ScotteC/candleLightFD/candleLightfd-S01.kicad_pcb

## KiCad design candleLightfd-S01.kicad_pcb (2024-10-16)

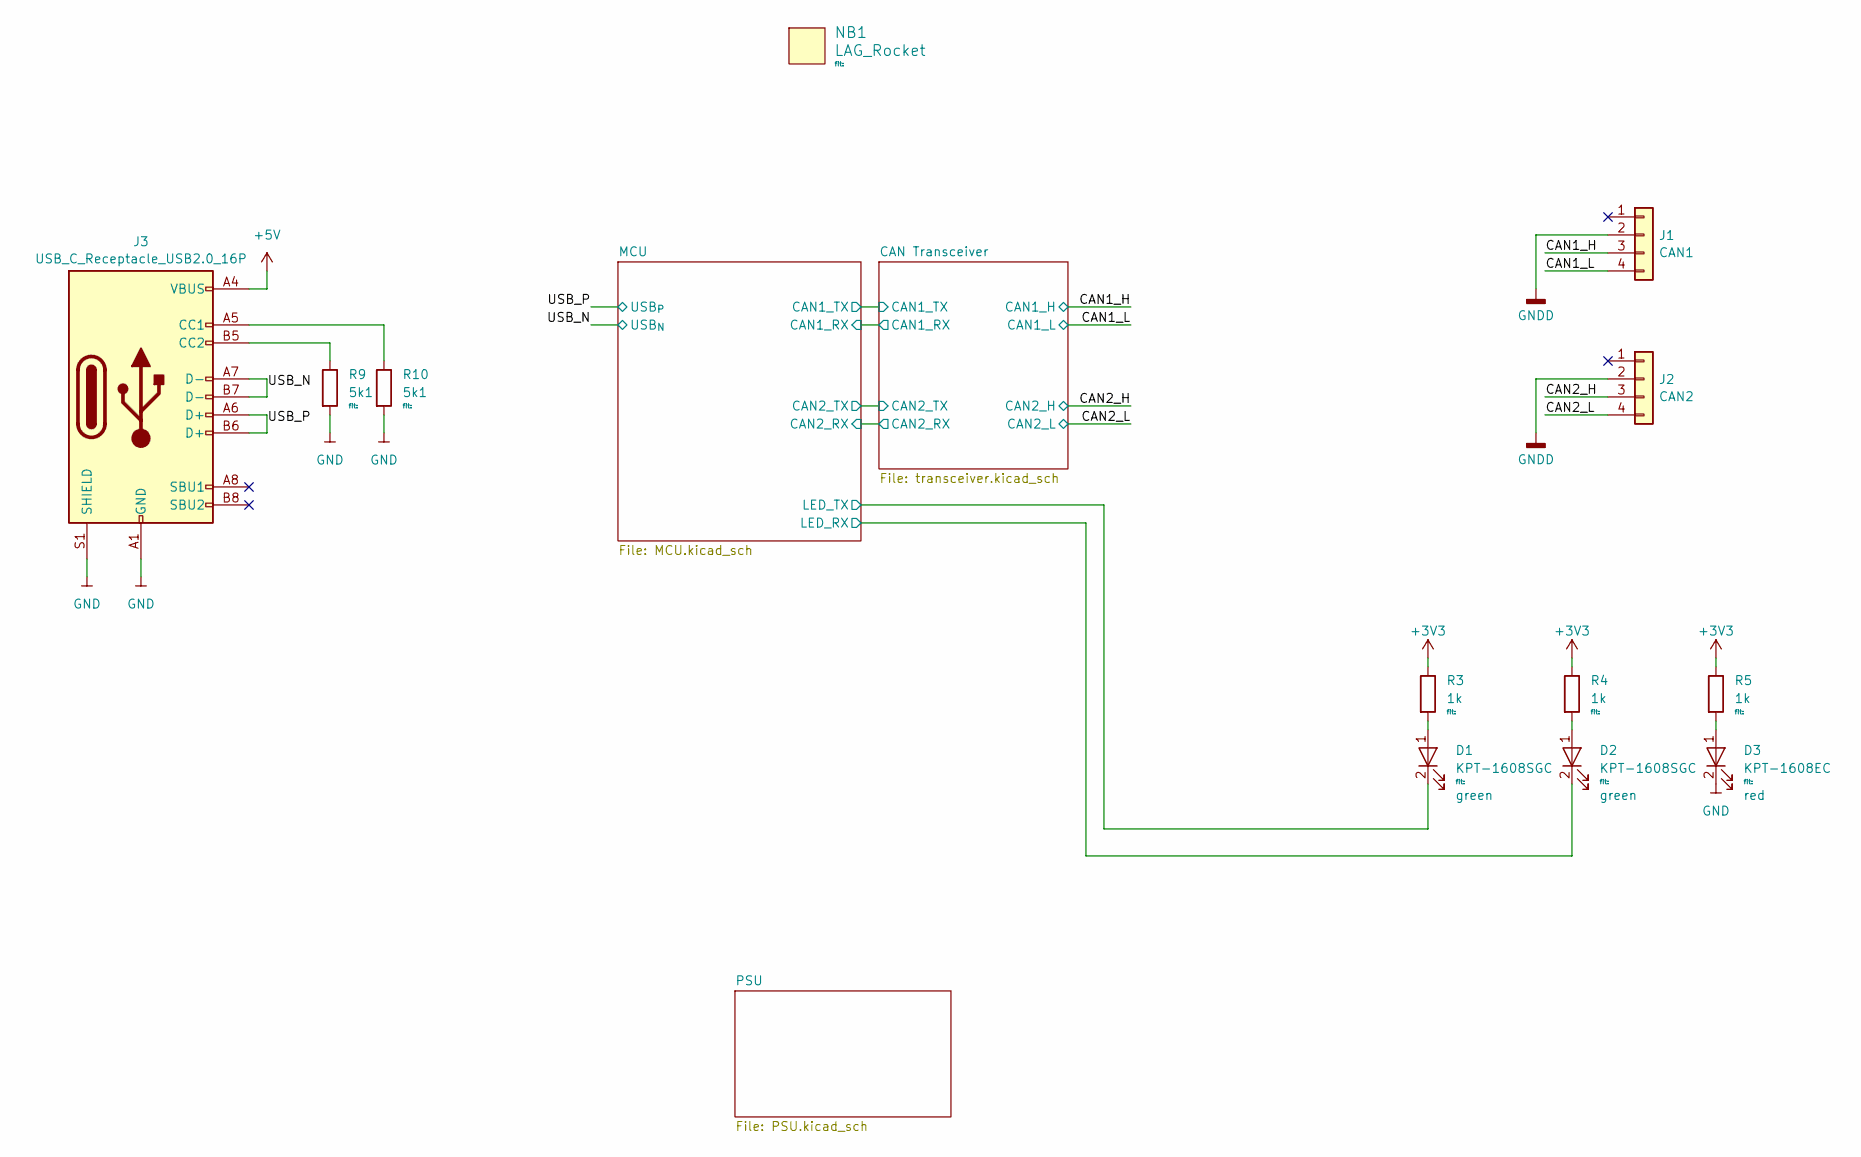
[picture p1: schematic candleLightfd-S01.kicad_sch, ${title}]

Parts:
D1, D2: KPT-1608SGC; LED_0603_1608Metric; MPN KPT-1608SGC
D3: KPT-1608EC; LED_0603_1608Metric; MPN KPT-1608EC
J1: CAN1; PSS254_1x04_Horizontal
J2: CAN2; PSS254_1x04_Horizontal
J3: USB_C_Receptacle_USB2.0_16P; USB_C_Receptacle_GCT_USB4085; MPN GSB1C411111DS1HR; mouser 523-GSB1C411111DS1HR
NB1: LAG_Rocket; lag_rocket_14.5mmx15mm
R3, R4, R5: 1k; R_0603_1608Metric
R9, R10: 5k1; R_0603_1608Metric

Connections:
+3V3: R3.1, R4.1, R5.1; also elsewhere on the board
+5V: J3.A4 (VBUS), J3.A9 (VBUS), J3.B4 (VBUS), J3.B9 (VBUS); also elsewhere on the board
/CAN1_H: J1.3; also elsewhere on the board
/CAN1_L: J1.4; also elsewhere on the board
/CAN2_H: J2.3; also elsewhere on the board
/CAN2_L: J2.4; also elsewhere on the board
/MCU/LED_RX: D2.2 (K); also elsewhere on the board
/MCU/LED_TX: D1.2 (K); also elsewhere on the board
/USB_N: J3.A7 (D-), J3.B7 (D-); also elsewhere on the board
/USB_P: J3.A6 (D+), J3.B6 (D+); also elsewhere on the board
GND: D3.2 (K), J3.A1 (GND), J3.A12 (GND), J3.B1 (GND), J3.B12 (GND), J3.S1 (SHIELD), R9.2, R10.2; also elsewhere on the board
GNDD: J1.2, J2.2; also elsewhere on the board
unnamed: D1.1 (A), R3.2
unnamed: D2.1 (A), R4.2
unnamed: D3.1 (A), R5.2
unnamed: J3.A5 (CC1), R10.1
unnamed: J3.B5 (CC2), R9.1

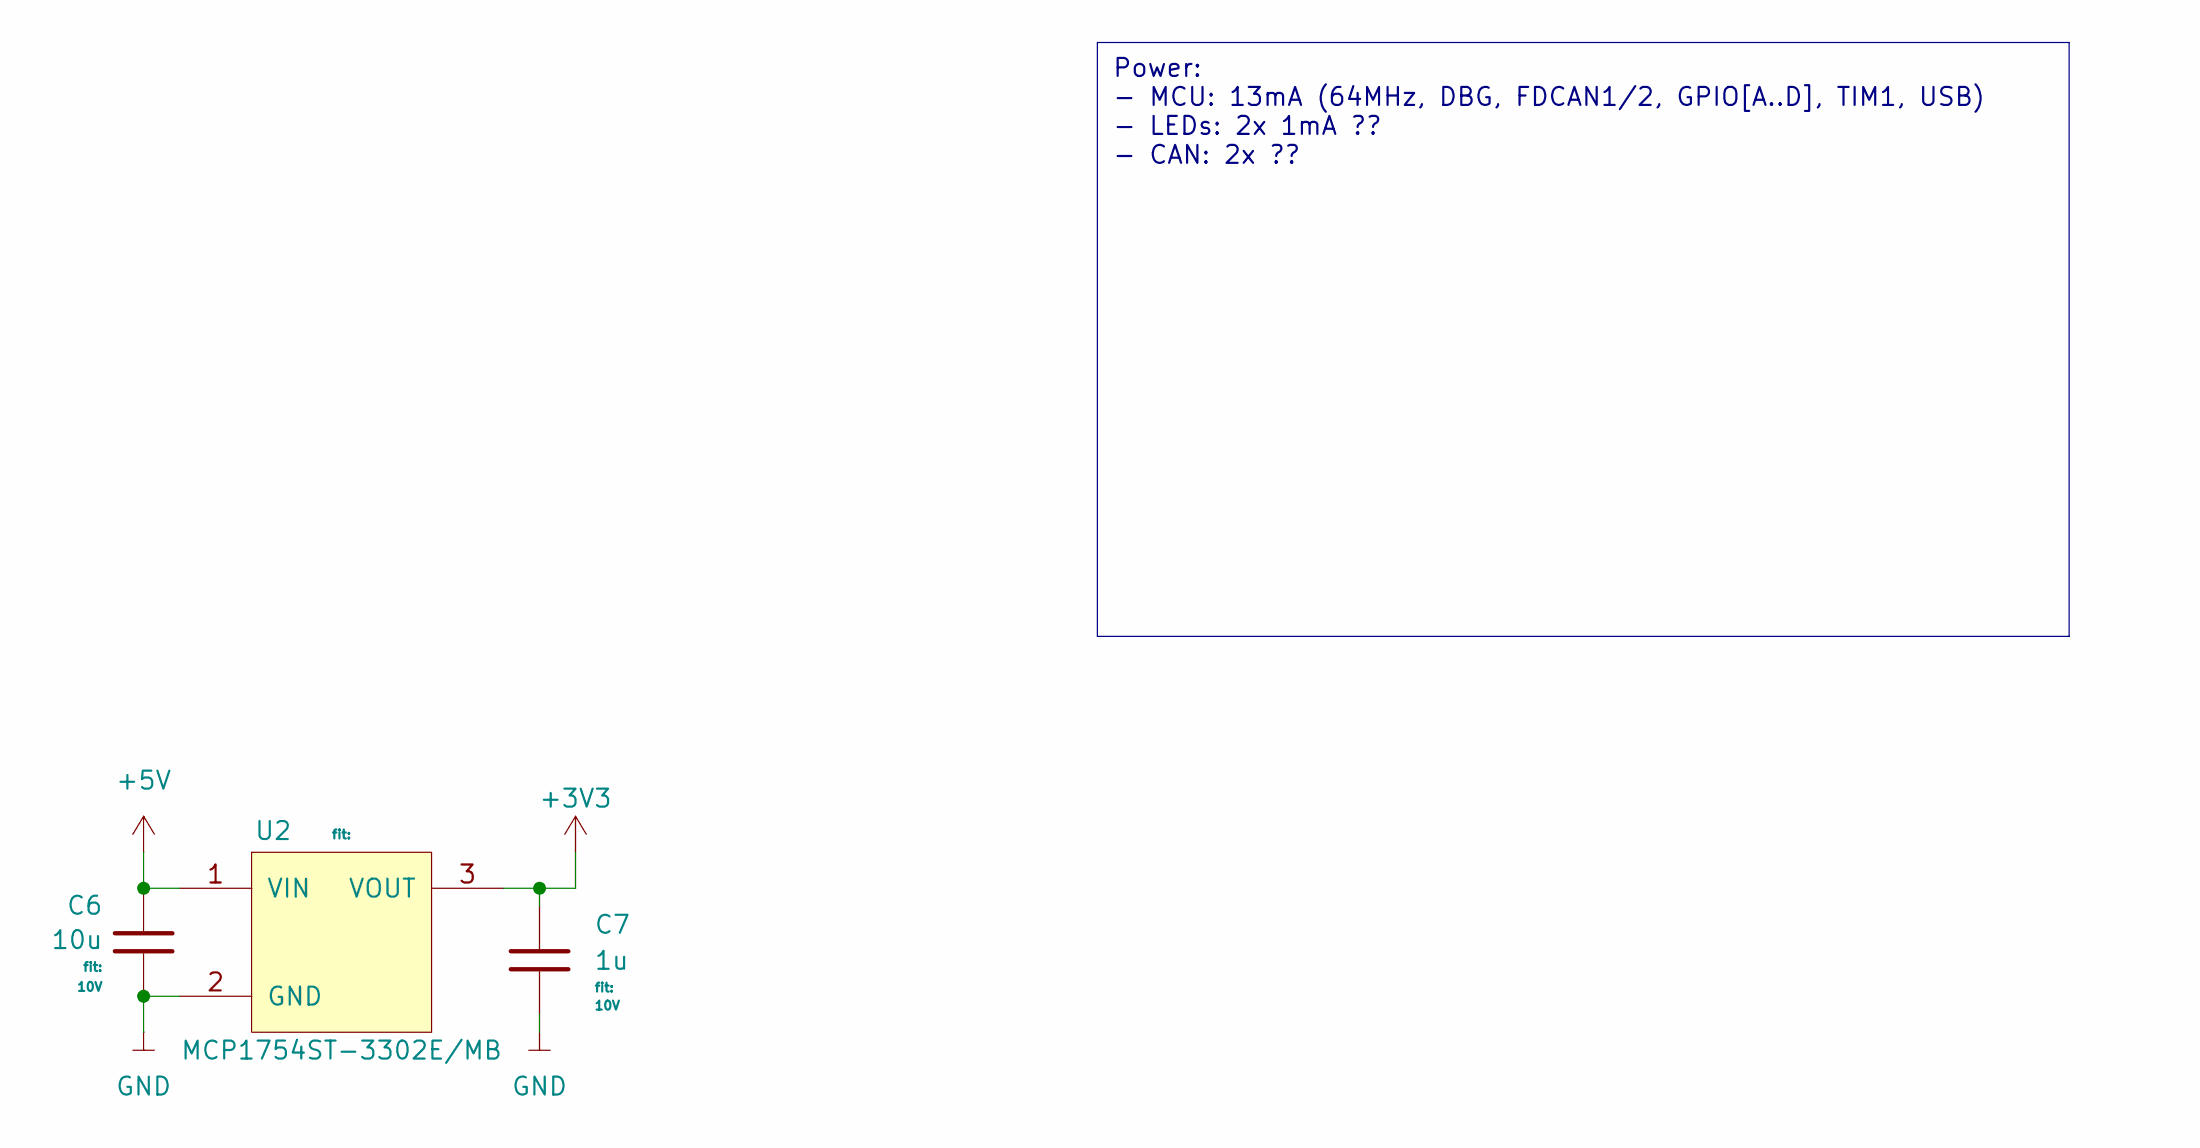
[picture p2: schematic PSU.kicad_sch, Power]

Parts:
C6: 10u; C_0603_1608Metric; MPN any
C7: 1u; C_0603_1608Metric; MPN any
U2: MCP1754ST-3302E/MB; SOT-89-3; MPN MCP1754ST-3302E/MB; digikey MCP1754ST-3302E/MBCT-ND

Connections:
+3V3: C7.1, U2.3 (VOUT); also elsewhere on the board
+5V: C6.1, U2.1 (VIN); also elsewhere on the board
GND: C6.2, C7.2, U2.2 (GND); also elsewhere on the board

Notes on the sheet:
Power: - MCU: 13mA (64MHz, DBG, FDCAN1/2, GPIO[A..D], TIM1, USB) - LEDs: 2x 1mA ?? - CAN: 2x ??

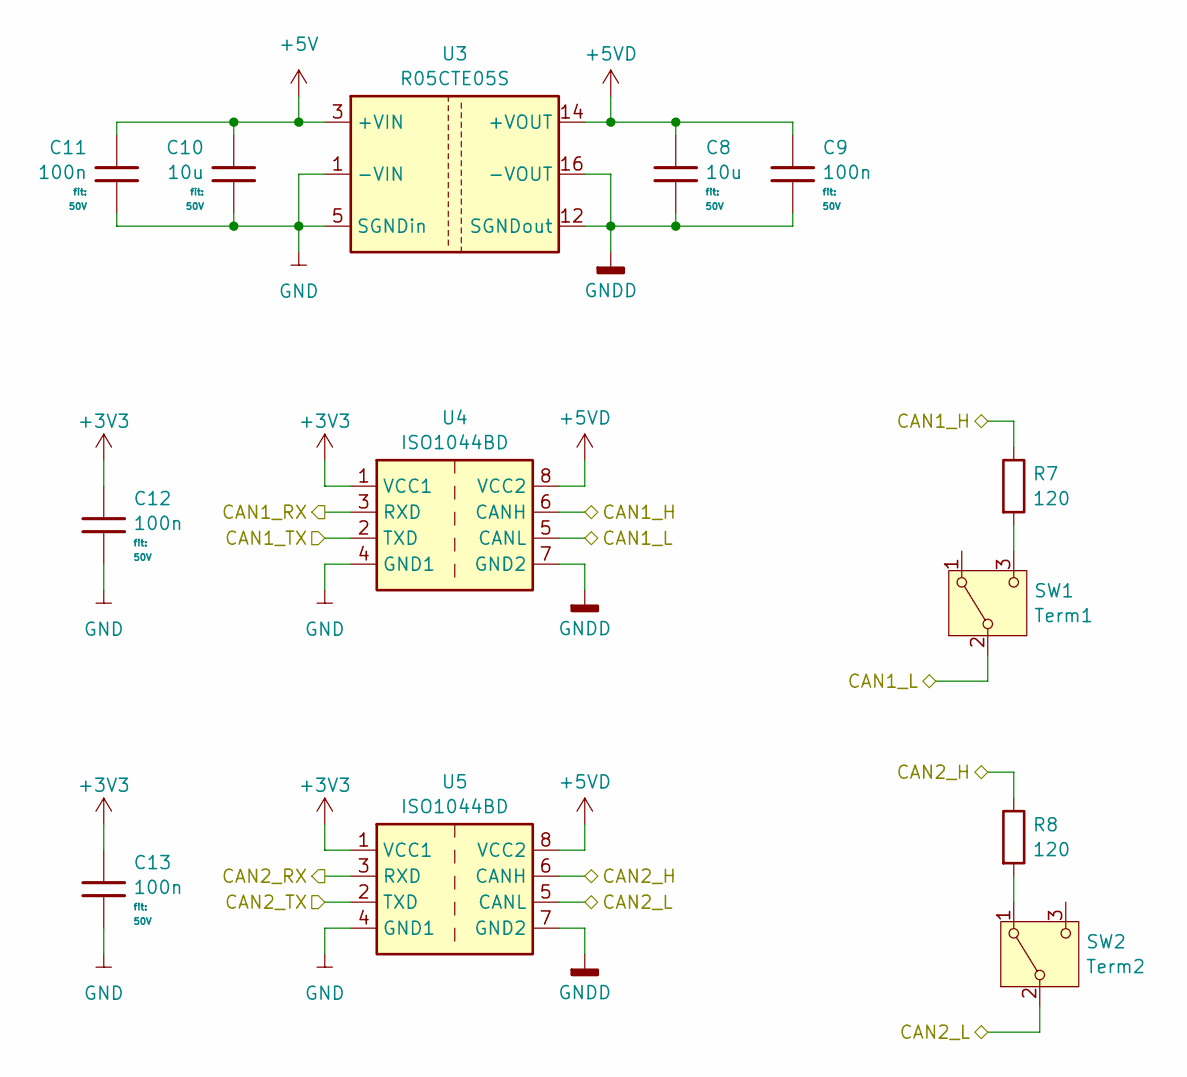
[picture p3: schematic transceiver.kicad_sch, Transiver]

Parts:
C8, C10: 10u; C_0603_1608Metric; MPN any
C9, C11, C12, C13: 100n; C_0603_1608Metric; MPN any
R7, R8: 120; R_0603_1608Metric
SW1: Term1; SW_Slide_SPDT_Angled_CK_OS102011MA1Q; MPN OS102011MA1QS1; digikey CKN9560-ND
SW2: Term2; SW_Slide_SPDT_Angled_CK_OS102011MA1Q; MPN OS102011MA1QS1; digikey CKN9560-ND
U3: R05CTE05S; SOIC-16W_7.5x10.3mm_P1.27mm; MPN R05CTE05S-R; digikey 945-R05CTE05S-RCT-ND
U4, U5: ISO1044BD; SOIC-8_3.9x4.9mm_P1.27mm; MPN ISO1044BDR; digikey 296-ISO1044BDRCT-ND

Connections:
+3V3: C12.1, C13.1, U4.1 (VCC1), U5.1 (VCC1); also elsewhere on the board
+5V: C10.1, C11.1, U3.3 (+VIN), U3.4 (+VIN); also elsewhere on the board
+5VD: C8.1, C9.1, U3.13 (+VOUT), U3.14 (+VOUT), U4.8 (VCC2), U5.8 (VCC2)
/CAN1_H: R7.1, U4.6 (CANH); also elsewhere on the board
/CAN1_L: SW1.2 (B), U4.5 (CANL); also elsewhere on the board
/CAN2_H: R8.1, U5.6 (CANH); also elsewhere on the board
/CAN2_L: SW2.2 (B), U5.5 (CANL); also elsewhere on the board
/CAN Transceiver/CAN1_RX: U4.3 (RXD); also elsewhere on the board
/CAN Transceiver/CAN1_TX: U4.2 (TXD); also elsewhere on the board
/CAN Transceiver/CAN2_RX: U5.3 (RXD); also elsewhere on the board
/CAN Transceiver/CAN2_TX: U5.2 (TXD); also elsewhere on the board
GND: C10.2, C11.2, C12.2, C13.2, U3.1 (-VIN), U3.2 (-VIN), U3.5 (SGNDin), U3.6 (SGNDin), U3.7 (SGNDin), U3.8 (SGNDin), U4.4 (GND1), U5.4 (GND1); also elsewhere on the board
GNDD: C8.2, C9.2, U3.9 (SGNDout), U3.11 (SGNDout), U3.12 (SGNDout), U3.15 (-VOUT), U3.16 (-VOUT), U4.7 (GND2), U5.7 (GND2); also elsewhere on the board
unnamed: R7.2, SW1.3 (C)
unnamed: R8.2, SW2.1 (A)

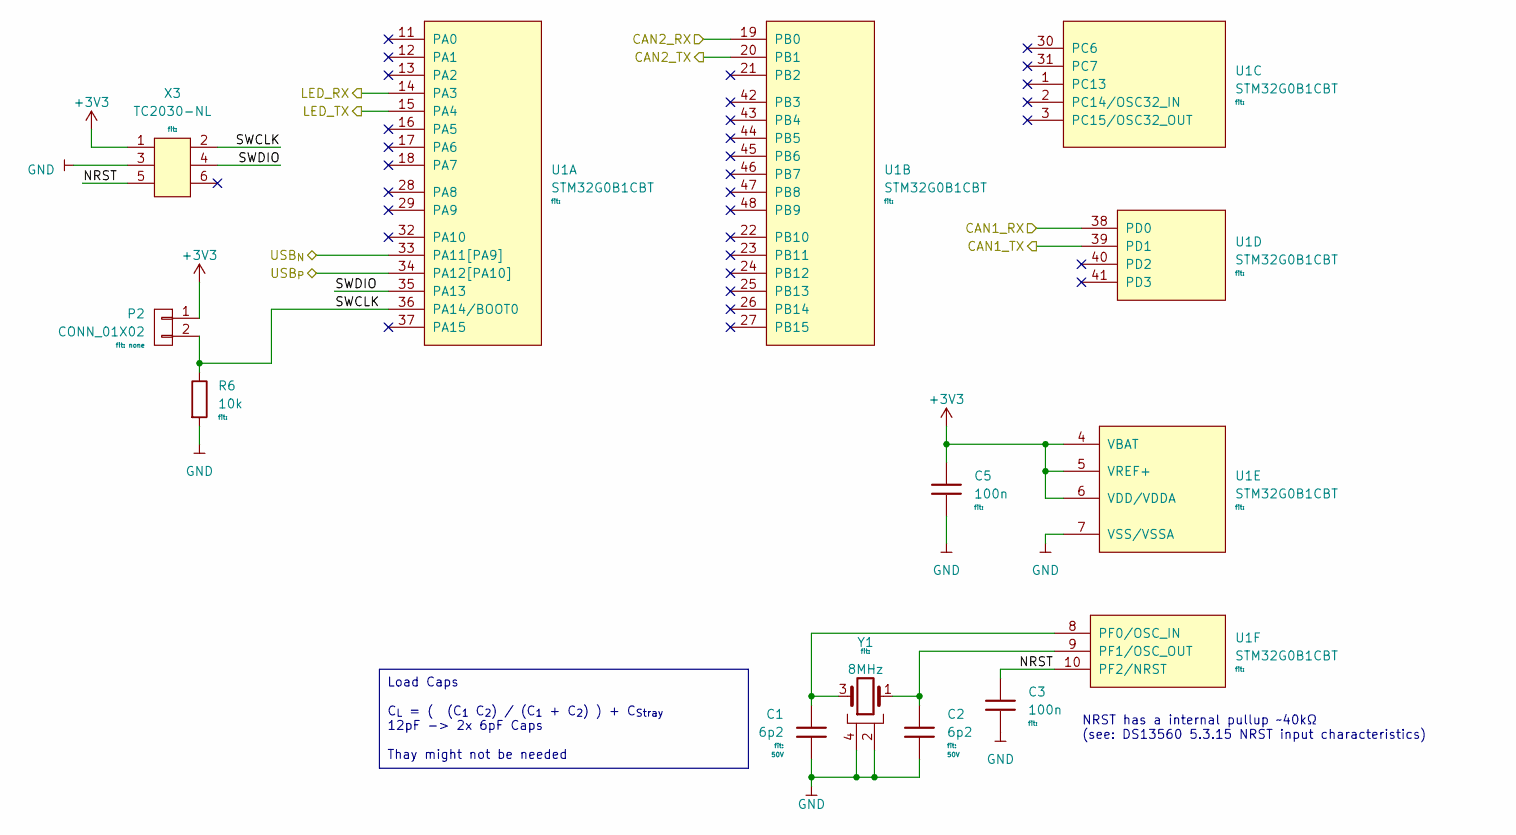
[picture p4: schematic MCU.kicad_sch]

Parts:
C1, C2: 6p2; C_0603_1608Metric; MPN CC0603BRNPO9BN6R2; digikey 13-CC0603BRNPO9BN6R2CT-ND
C3, C5: 100n; C_0603_1608Metric; MPN any
P2: CONN_01X02; SolderJumper-2_P1.3mm_Open_RoundedPad1.0x1.5mm; MPN generic
R6: 10k; R_0603_1608Metric
U1: STM32G0B1CBT; LQFP-48_7x7mm_P0.5mm; MPN STM32G0B1CBT; mouser 511-STM32G0B1CBT3
X3: TC2030-NL; MPN TC2030-NL
Y1: 830108313809; Crystal_SMD_3225-4Pin_3.2x2.5mm; MPN 830108313809; mouser 710-830108313809

Connections:
+3V3: C5.1, P2.1, U1.4 (VBAT), U1.5 (VREF+), U1.6 (VDD/VDDA), X3.1; also elsewhere on the board
/CAN Transceiver/CAN1_RX: U1.38 (PD0); also elsewhere on the board
/CAN Transceiver/CAN1_TX: U1.39 (PD1); also elsewhere on the board
/CAN Transceiver/CAN2_RX: U1.19 (PB0); also elsewhere on the board
/CAN Transceiver/CAN2_TX: U1.20 (PB1); also elsewhere on the board
/MCU/LED_RX: U1.14 (PA3); also elsewhere on the board
/MCU/LED_TX: U1.15 (PA4); also elsewhere on the board
/MCU/NRST: C3.1, U1.10 (PF2/NRST), X3.5 (P4)
/MCU/SWCLK: P2.2, R6.1, U1.36 (PA14/BOOT0), X3.2
/MCU/SWDIO: U1.35 (PA13), X3.4
/USB_N: U1.33 (PA11[PA9]); also elsewhere on the board
/USB_P: U1.34 (PA12[PA10]); also elsewhere on the board
GND: C1.1, C2.1, C3.2, C5.2, R6.2, U1.7 (VSS/VSSA), X3.3, Y1.2 (GND), Y1.4 (GND); also elsewhere on the board
unnamed: C1.2, U1.8 (PF0/OSC_IN), Y1.3 (C_{2})
unnamed: C2.2, U1.9 (PF1/OSC_OUT), Y1.1 (C_{1})

Notes on the sheet:
Load Caps C_{L} = ( (C_{1} C_{2}) / (C_{1} + C_{2}) ) + C_{Stray} 12pF -> 2x 6pF Caps Thay might not be needed
NRST has a internal pullup ~40kΩ (see: DS13560 5.3.15 NRST input characteristics)

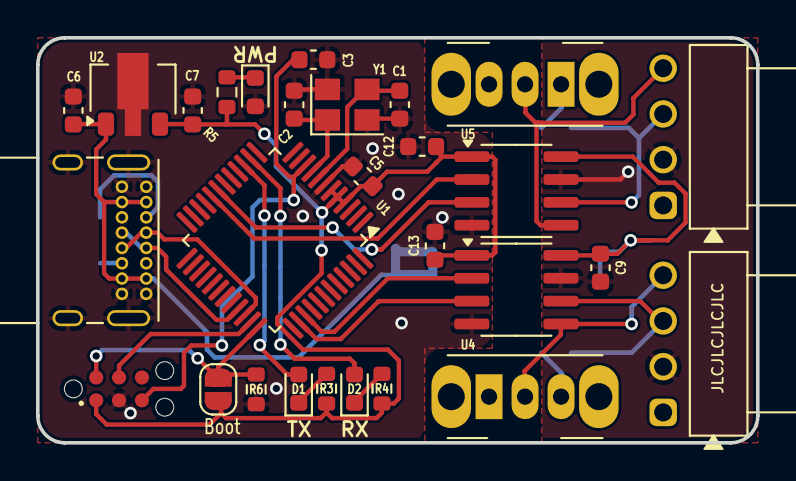
[picture p5: board candleLightfd-S01.kicad_pcb from above]

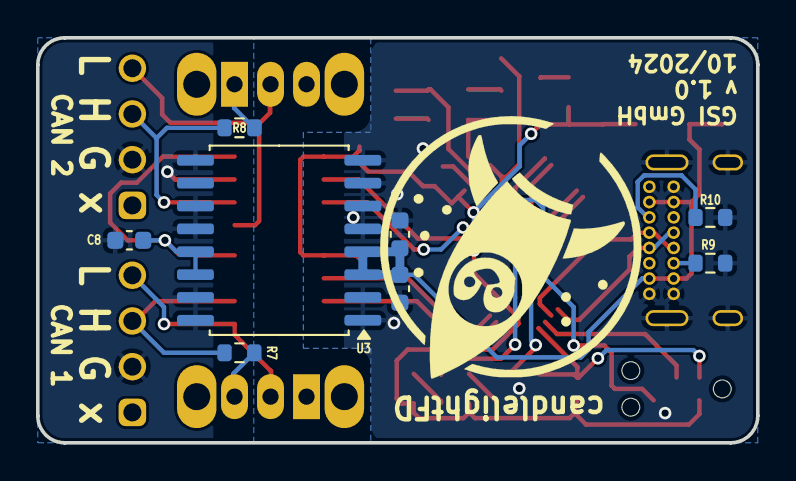
[picture p6: board candleLightfd-S01.kicad_pcb from below]

Board: 2 copper layers, 40.0 x 22.5 mm, 37 parts (9 on the bottom side), 29 nets.
