ScotteC/candleLightFD/(commit log)

2024-10-15 clean up
    [MCU.kicad_sch, PSU.kicad_sch, candleLightfd-S01.kicad_pcb, candleLightfd-S01.kicad_sch, transceiver.kicad_sch]
2024-10-15 replace connector CAN1/2 with PSS
    [MCU.kicad_sch, PSU.kicad_sch, candleLightfd-S01.kicad_pcb, candleLightfd-S01.kicad_sch, transceiver.kicad_sch]
2024-10-16 ready for production
    [MCU.kicad_sch, PSU.kicad_sch, candleLightfd-S01.kicad_pcb, candleLightfd-S01.kicad_sch, transceiver.kicad_sch]
